notazizelse/camp/docs/images/pcb-top.png

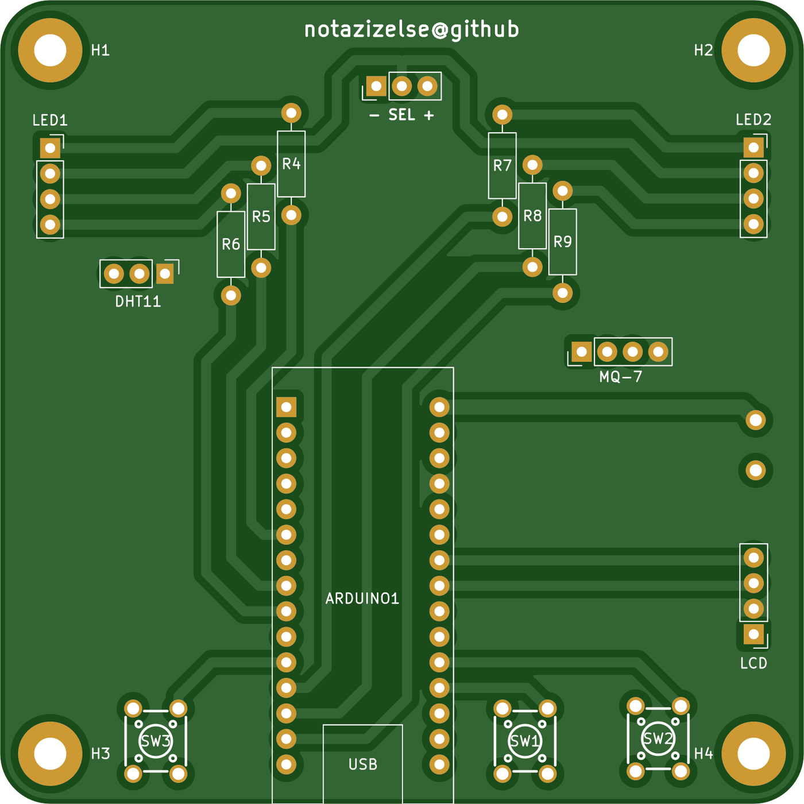
docs/images/pcb-top.png
