notazizelse/camp/production/smeta_cubesat_camp_19-20.09.2026.xlsx

Sheet: Смета
СМЕТА — TechnoCamp CubeSat, 19–20 сентября 2026
Плата campv2 (80×80 мм, 2 слоя) · 25 учеников · 25 CubeSat · 30 плат · 2 дня по 6–7 ч · 1 преподаватель + 3 ассистента
Все цены в USD. Цены JLCPCB — живая котировка jlcpcb.com от 08.09.2026. Остальные цены — оценка розничного рынка Ташкента на сентябрь 2026; уточните у поставщика.
ПАРАМЕТРЫ (жёлтые ячейки можно менять — количества пересчитаются)
Учеников (= CubeSat) | 25
Плат заказываем | 30
Паяльных станций | 12
Дней лагеря | 2
Часов в день | 6.5
№ | Позиция | Зачем нужно | Кол-во | Ед. | Цена, $ | Сумма, $ | Статус | Где брать | Примечание
A. ПЕЧАТНЫЕ ПЛАТЫ — JLCPCB
1 | Изготовление 30 плат 80×80 мм, 2 слоя, FR-4, HASL, зелёная | Основа CubeSat | 1 | заказ | $30.00 | $30.00 | Купить | JLCPCB | Котировка на 50 шт от 08.09.2026: инж. сбор $8.00 + плёнки $1.80 + платы $23.70 = $33.50. Для 30 шт немного меньше
2 | Ускорение производства до 2–3 дней | Иначе платы не успевают к 19 сентября | 1 | опция | $12.30 | $12.30 | Купить | JLCPCB | КРИТИЧНО. Стандартный срок 5–6 дней даёт прибытие 17–21 сентября — риск
3 | Доставка DHL Express (DDP) до Ташкента, ~1 кг | 2–4 рабочих дня | 1 | доставка | $30.48 | $30.48 | Купить | JLCPCB | Сайт сам определил Узбекистан как страну доставки
4 | Купон новичка JLCPCB | Скидка при первом заказе | 1 | скидка | -$20.00 | -$20.00 | Купить | JLCPCB | Применяется, если аккаунт новый. Если нет — уберите строку
 | Итого по разделу «A» |  |  |  |  | $52.78
B. КОМПОНЕНТЫ НА ПЛАТУ (на 30 плат + запас)
5 | Arduino Nano V3, CH340/CH9102, распаянный | Мозг CubeSat, 1 на плату | 35 | шт | $4.00 | $140.00 | Купить | Ташкент, радиорынок | +5 в запас: новички их убивают перегревом и переполюсовкой
6 | Гребёнка-мама PBS 1×40 (режется на 2 шт по 15) | Панельки под Nano — съёмный и защищён от перегрева | 35 | шт | $0.50 | $17.50 | Купить | Ташкент | ОБЯЗАТЕЛЬНО. Заливка +5V идёт по всей лицевой стороне под Nano — прямая пайка рискует замыканием
7 | Резистор 220 Ом, 0.25 Вт, выводной | Токоограничение RGB, 6 шт на плату | 250 | шт | $0.02 | $5.00 | Купить | Ташкент | 30 плат × 6 = 180 + запас на потери
8 | Кнопка тактовая 6×6×5 мм, 4 вывода | SW1–SW3, переключение экранов | 110 | шт | $0.07 | $7.70 | Купить | Ташкент | 30 × 3 = 90 + запас
9 | RGB светодиод 5 мм, 4 вывода, ОБЩИЙ КАТОД | LED2/LED3 — индикация температуры и CO | 75 | шт | $0.25 | $18.75 | Купить | Ташкент | ТОЛЬКО общий катод. Код рассчитан на него (проверено по даташиту LCSC C2837020). Общий анод даст инверсию цветов
10 | Панелька PBS 1×4 | Гнездо под RGB — светодиод съёмный | 70 | шт | $0.10 | $7.00 | Купить | Ташкент | Так задумано в футпринте платы
11 | Гребёнка-папа PLS 1×40 (режется на J2–J5) | Разъёмы датчиков и LCD, 14 контактов на плату | 15 | шт | $0.30 | $4.50 | Купить | Ташкент | 30 плат × 14 = 420 контактов ≈ 11 полосок + запас
12 | Клеммник винтовой DG301, шаг 5 мм, 2 контакта | U1 — вход питания | 35 | шт | $0.30 | $10.50 | Купить | Ташкент | На плате стоит с ОБРАТНОЙ стороны — проверьте, что это так задумано
13 | Джампер-перемычка 2.54 мм | J5: подключает общий вывод RGB к GND | 40 | шт | $0.05 | $2.00 | Купить | Ташкент | Легко забыть при закупке. Без неё светодиоды просто не горят
14 | Стойка латунная M3×10 + винт M3×6 | Крепёж платы к корпусу, 4 комплекта на плату | 120 | компл | $0.12 | $14.40 | Купить | Ташкент | Отверстия на плате 3.2 мм под M3
 | Итого по разделу «B» |  |  |  |  | $227.35
C. ВНЕШНИЕ МОДУЛИ (на 25 CubeSat + запас)
15 | LCD 1602 + плата I2C (PCF8574) | Экран CubeSat, подключается к J3 | 28 | шт | $4.50 | $126.00 | Купить | Ташкент | I2C-адрес 0x27 или 0x3F — в коде есть переключатель LCD_ADDRESS
16 | Модуль DHT11, 3-выводной | Температура и влажность, к J2 | 28 | шт | $2.00 | $56.00 | Купить | Ташкент | ПРОВЕРИТЬ порядок выводов: плата ждёт 5V–DATA–GND, у части модулей S–+–−
17 | Модуль MQ-7 (угарный газ) | Датчик CO, к J4 | 28 | шт | $3.50 | $98.00 | Купить | Ташкент | Нагреватель ест ~150 мА. Нужен прогрев 24–48 ч до калибровки — включите за день до лагеря
18 | Провода Dupont мама-мама 20 см, набор 40 шт | Подключение модулей, 11 проводов на CubeSat | 12 | набор | $2.00 | $24.00 | Купить | Ташкент | 25 CubeSat × 11 = 275 проводов
 | Итого по разделу «C» |  |  |  |  | $304.00
D. ПИТАНИЕ CUBESAT (2×18650 Li-ion)
19 | Аккумулятор 18650 Li-ion, 2000–2600 мА·ч, брендовый | 2 шт последовательно = 7.4 В на клеммник | 56 | шт | $3.50 | $196.00 | Купить | Ташкент | 25 CubeSat × 2 + 6 в запас. НЕ берите ячейки с надписью «9800 mAh» — это восстановленные, ёмкость в 5 раз ниже заявленной
20 | Холдер 2×18650, последовательный, с выводами | Держатель батарей в корпусе | 28 | шт | $1.20 | $33.60 | Купить | Ташкент | Последовательное соединение, не параллельное — нужно 7.4 В
21 | Плата защиты BMS 2S, 8.4 В, 5–10 А | Защита от переразряда, перезаряда и КЗ | 28 | шт | $1.00 | $28.00 | Купить | Ташкент | ОБЯЗАТЕЛЬНО. Li-ion без защиты в руках 25 подростков — это пожар, а не проект
22 | Зарядное устройство 18650, 4 слота, с индикацией | Зарядка ячеек по отдельности | 4 | шт | $9.00 | $36.00 | Купить | Ташкент | Поячеечная зарядка проще и безопаснее балансирного зарядника 2S
23 | Выключатель клавишный на корпус | На плате выключателя нет — CubeSat должен уметь выключаться | 28 | шт | $0.50 | $14.00 | Купить | Ташкент | Ставится в разрыв «+» между BMS и клеммником
24 | Провод AWG22 + термоусадка + клеммные наконечники | Сборка батарейного узла | 1 | компл | $8.00 | $8.00 | Купить | Ташкент
 | Итого по разделу «D» |  |  |  |  | $315.60
E. КОРПУС CUBESAT (лазерная резка, фанера 3–4 мм)
25 | Лазерная резка: комплект деталей корпуса на 1 CubeSat | Каркас спутника | 28 | компл | $2.50 | $70.00 | Купить | Резчик в Ташкенте | Механики в проекте пока нет — макет надо нарисовать до лагеря. Учтите вырез под USB: Nano выступает за край платы на 2.7 мм
26 | Фанера 3 мм, лист 600×600 мм | Материал под резку | 8 | лист | $4.00 | $32.00 | Купить | Строительный рынок | Если резчик работает по давальческому материалу. Иначе входит в цену резки
27 | Термоклеевой пистолет | Сборка корпуса | 4 | шт | $6.00 | $24.00 | Купить | Ташкент
28 | Стержни термоклея 11 мм | Расходник | 40 | шт | $0.15 | $6.00 | Купить | Ташкент
29 | Наждачная бумага P180/P240 | Зачистка кромок фанеры после резки | 20 | лист | $0.25 | $5.00 | Купить | Ташкент
 | Итого по разделу «E» |  |  |  |  | $137.00
F. ПАЯЛЬНОЕ ОБОРУДОВАНИЕ (12 станций)
30 | Паяльная станция с регулировкой температуры, 60 Вт | 12 станций = 2 волны по 12–13 учеников | 12 | шт | $22.00 | $264.00 | Купить | Ташкент | ОБЯЗАТЕЛЬНО с регулировкой. Без неё новички отрывают пятаки и жгут Nano. 3 ассистента × 4 станции — правильная плотность присмотра
31 | Жало сменное, конус / скос 2 мм | Расходник, 2 на станцию | 24 | шт | $1.50 | $36.00 | Купить | Ташкент | За 2 дня новички гарантированно испортят несколько
32 | Коврик силиконовый термостойкий | Защита столов | 12 | шт | $4.00 | $48.00 | Купить | Ташкент
33 | «Третья рука» с лупой | Держать плату при пайке | 12 | шт | $4.00 | $48.00 | Купить | Ташкент | Сильно ускоряет новичка
34 | Бокорезы | Откусывание выводов после пайки | 12 | шт | $2.50 | $30.00 | Купить | Ташкент
35 | Пинцет прямой | Установка мелких деталей | 12 | шт | $1.50 | $18.00 | Купить | Ташкент
36 | Держатель печатной платы | Фиксация при пайке | 6 | шт | $3.00 | $18.00 | Купить | Ташкент
 | Итого по разделу «F» |  |  |  |  | $462.00
G. РАСХОДНИКИ ПАЙКИ
37 | Припой Sn60Pb40, 0.8 мм, с канифолью, 250 г | Основной расходник | 3 | катушка | $8.00 | $24.00 | Купить | Ташкент | Расчёт: 25 плат × 78 точек ≈ 2000 точек × ~0.1 г + тренировка + переделки ≈ 500–750 г
38 | Флюс-гель (или канифоль) | Смачиваемость, чистая пайка | 6 | шт | $2.00 | $12.00 | Купить | Ташкент
39 | Оплётка для выпайки, 2 мм | Снятие соплей и перемычек | 6 | шт | $2.00 | $12.00 | Купить | Ташкент | Понадобится точно: ждите 20–30% плат с ошибками
40 | Отсос для припоя (оловоотсос) | Исправление ошибок | 4 | шт | $4.00 | $16.00 | Купить | Ташкент
41 | Изопропиловый спирт 500 мл + кисти | Отмывка флюса перед проверкой | 2 | компл | $6.00 | $12.00 | Купить | Ташкент
42 | Салфетки безворсовые | Отмывка | 2 | упак | $2.50 | $5.00 | Купить | Ташкент
43 | Макетная плата-обрезок для тренировки | 20 минут тренировки перед реальной платой | 25 | шт | $0.60 | $15.00 | Купить | Ташкент | Ученик не должен учиться паять на своей единственной плате
44 | Набор «учусь паять» (мигающий светодиод) | Быстрая победа до реальной платы | 25 | набор | $1.50 | $37.50 | Купить | Ташкент / AliExpress | Опционально, но сильно поднимает уверенность новичка
 | Итого по разделу «G» |  |  |  |  | $133.50
H. КОНТРОЛЬ И ИЗМЕРЕНИЯ (станция ОТК)
45 | Мультиметр цифровой | ГЛАВНОЕ: прозвонка +5V ↔ GND ДО подачи питания | 5 | шт | $12.00 | $60.00 | Купить | Ташкент | Заливка +5V идёт по всей лицевой стороне: любая сопля на полигон = короткое замыкание. Ни одна плата не включается без этой проверки
46 | USB-тестер тока и напряжения | Бросок тока сразу показывает КЗ | 3 | шт | $6.00 | $18.00 | Купить | Ташкент
47 | Повербанк 5000 мА·ч | ПЕРВОЕ включение платы — только от него | 4 | шт | $8.00 | $32.00 | Купить | Ташкент | Никогда не включать непроверенную плату в порт MacBook
48 | Лупа настольная с подсветкой | Осмотр пайки на станции ОТК | 2 | шт | $15.00 | $30.00 | Купить | Ташкент
 | Итого по разделу «H» |  |  |  |  | $140.00
I. КОМПЬЮТЕРЫ И ПЕРИФЕРИЯ
49 | MacBook Air M5 13" | KiCAD + Arduino IDE, 1 на ученика | 25 | шт | $1199.00 | $29975.00 | Есть | — | В наличии. Указано справочно, чтобы смета отражала полную стоимость программы
50 | Переходник USB-C → USB-A | У MacBook нет USB-A, а Nano подключается через него | 25 | шт | $4.00 | $100.00 | Купить | Ташкент | Без них 25 учеников не смогут прошить ни одной платы
51 | Кабель USB mini-B (или micro-B), 1 м | Прошивка Nano | 30 | шт | $1.50 | $45.00 | Купить | Ташкент | УТОЧНИТЬ тип разъёма на закупленных Nano — бывают и mini, и micro
52 | USB-хаб на 4 порта | Станции массовой прошивки | 4 | шт | $10.00 | $40.00 | Купить | Ташкент
53 | Проектор или большой экран | Разбор схемы и демонстрация KiCAD | 1 | шт | $0.00 | $0.00 | Проверить | — | Уточните наличие в зале — в смете стоит 0
 | Итого по разделу «I» |  |  |  |  | $30160.00
J. БЕЗОПАСНОСТЬ
54 | Дымоуловитель настольный с угольным фильтром | 12 паяльников дают много дыма канифоли | 4 | шт | $18.00 | $72.00 | Купить | Ташкент | Общая вентиляция у вас есть, но локальный отсос у паяльных мест нужен отдельно
55 | Сменные угольные фильтры | Расходник | 8 | шт | $2.00 | $16.00 | Купить | Ташкент
56 | Очки защитные прозрачные | Обрезки выводов летят в глаза | 30 | шт | $1.50 | $45.00 | Купить | Ташкент | Обязательно при откусывании выводов
57 | Огнестойкий бокс для хранения и зарядки Li-ion | Аккумуляторы 18650 хранятся и заряжаются только в нём | 2 | шт | $15.00 | $30.00 | Купить | Ташкент | Заряжать только под присмотром взрослого и никогда не оставлять на ночь без надзора
58 | Аптечка + гель/спрей от ожогов | Ожоги о жало — самая частая травма | 1 | компл | $25.00 | $25.00 | Купить | Аптека
59 | Огнетушитель CO2, 2 кг | Требование безопасности | 1 | шт | $35.00 | $35.00 | Проверить | — | Скорее всего есть в помещении — проверьте до лагеря
 | Итого по разделу «J» |  |  |  |  | $223.00
K. ОРГАНИЗАЦИЯ И МЕТОДИКА
60 | Печать инструкции по сборке, A4 цветная, 4 стр. | Что куда паять, порядок, фото платы | 30 | компл | $0.60 | $18.00 | Купить | Типография | Резко снижает число вопросов к ассистентам
61 | Zip-пакеты для комплектов по ученику | Всё для одного CubeSat в одном пакете | 60 | шт | $0.15 | $9.00 | Купить | Ташкент | Расфасовка заранее экономит около часа в первый день
62 | Наклейки для маркировки комплектов | Имя ученика на пакете и плате | 2 | лист | $1.50 | $3.00 | Купить | Ташкент
63 | Органайзер-контейнер для мелочи | Резисторы, кнопки, светодиоды по ячейкам | 6 | шт | $3.00 | $18.00 | Купить | Ташкент
64 | Маркеры, скотч, стяжки, канцелярия | Прочее | 1 | компл | $15.00 | $15.00 | Купить | Ташкент
 | Итого по разделу «K» |  |  |  |  | $63.00
 | ИТОГО К ЗАКУПКЕ (только строки со статусом «Купить») |  |  |  |  | $2208.23
 | Стоимость на одного ученика (закупка) |  |  |  |  | $88.33
 | Уже в наличии (справочно: ноутбуки, столы, вентиляция, макетки) |  |  |  |  | $29975.00
 | ПОЛНАЯ СТОИМОСТЬ ПРОГРАММЫ (закупка + имеющееся) |  |  |  |  | $32183.23
 | ЛЕГЕНДА: синим на жёлтом — ячейки, которые нужно править (цены и параметры). Чёрным — формулы, их трогать не нужно.
 | Статус «Купить» попадает в итог закупки. Статус «Есть» и «Проверить» — нет.

Sheet: План лагеря
ПЛАН ЛАГЕРЯ — 19–20 сентября 2026
РАСЧЁТ УЗКОГО МЕСТА
Параметр | Значение | Откуда | Комментарий
Точек пайки на плате | 78 | Посчитано по campv2.kicad_pcb: 82 пятака минус 4 крепёжных отверстия
из них панельки под Nano | 30 | Две гребёнки 1×15 — 38% всей работы и самая сложная часть | ПРЕДЛОЖЕНИЕ: припаять их заранее силами взрослых
Остаётся ученику | 48 | Резисторы, кнопки, панельки RGB, разъёмы, клеммник
Скорость новичка | ~75 сек/точка | После 20 минут тренировки, включая подготовку детали и откусывание
Время на плату | ~70 мин | 48 × 75 сек + осмотр | Без предпайки панелек было бы ~95 мин
Всего паяльнико-часов | ~29 ч | 25 учеников × 70 мин
Паяльных станций | 12 | 25 учеников = 2 волны по 12–13 | 3 ассистента × 4 станции — правильная плотность присмотра
Чистое время пайки | ~2.4 ч | 29 ч ÷ 12 станций | Помещается в 2 дня с большим запасом
РОЛИ ВЗРОСЛЫХ
Кто | Роль | Отвечает за | Инструменты
Вы (ведущий) | Трек KiCAD + общее ведение | Теория, разбор схемы, KiCAD, экспорт герберов, тайминг дня | Проектор, MacBook
Ассистент 1 | Паяльный этаж, станции 1–6 | Техника пайки, безопасность, помощь по месту | 6 станций
Ассистент 2 | Паяльный этаж, станции 7–12 | То же | 6 станций
Ассистент 3 | СТАНЦИЯ ОТК | Проверяет КАЖДУЮ плату до подачи питания. Ведёт список переделок | Мультиметр, лупа, повербанк, оплётка, отсос
ПРАВИЛО №1: ни одна плата не включается до прозвонки +5V ↔ GND на станции ОТК. Заливка +5V идёт по всей лицевой стороне — любая сопля на полигон даёт короткое замыкание. Первое включение — только от повербанка, никогда не от MacBook.
ДЕНЬ 1 — суббота 19 сентября (6.5 ч)
Время | Кто | Основное | Параллельно
0:00–0:40 | ВСЕ | Открытие. Что такое CubeSat, разбор схемы на проекторе, показ готового образца | —
0:40–1:00 | ВСЕ | Техника безопасности + демо пайки у одного стола | —
1:00–3:15 | Волна 1 | Группа A (12 чел): 20 мин тренировка на обрезках + 70 мин плата | Группа B (13 чел): KiCAD — схема, символы, цепи
3:15–4:00 | ВСЕ | Обед | —
4:00–6:15 | Волна 2 | Группа B (13 чел): пайка | Группа A (12 чел): KiCAD — разводка платы, экспорт герберов
6:15–6:30 | ВСЕ | Сдача плат на ОТК, итоги дня, список переделок на завтра | —
ДЕНЬ 2 — воскресенье 20 сентября (6.5 ч)
Время | Кто | Основное | Параллельно
0:00–0:45 | ВСЕ | Разбор ошибок с ОТК, переделка проблемных плат (обычно 20–30%) | Ассистенты 1–3 на переделках
0:45–2:15 | ВСЕ | Прошивка: подключение LCD/DHT11/MQ-7, заливка CubeSat.ino, отладка | 25 MacBook — идёт одной волной
2:15–2:30 | ВСЕ | Перерыв | —
2:30–4:15 | ВСЕ | Сборка корпуса CubeSat из фанеры, установка платы на стойки | Термоклей, наждачка
4:15–5:00 | ВСЕ | Обед | —
5:00–6:00 | ВСЕ | Финальная интеграция, калибровка MQ-7, тесты | —
6:00–6:30 | ВСЕ | Демонстрация проектов, фото, закрытие | —
ПИТАНИЕ: 2×18650 (7.4 В) идут на клеммник → вывод VIN Arduino Nano → штатный линейный регулятор AMS1117. При включённом MQ-7 (~150 мА) регулятор рассеивает ~0.6 Вт и заметно греется. Это рабочий режим, но отладку в лагере лучше вести от повербанка через USB, а батареи включать на финальную демонстрацию автономности.

Sheet: Чек-лист подготовки
ЧЕК-ЛИСТ ПОДГОТОВКИ — до 19 сентября
Отмечайте «Готово» в колонке C. Порядок — по срочности.
№ | Что сделать | Срок | Кто | Почему это важно
1 | Исправить шелкографию: подписи выводов J2/J3/J4/J5, маркер 1-го вывода | 9 сентября | Вы | Без подписей 25 новичков перепутают подключение датчиков
2 | Перенести метки «+»/«−» клеммника со слоя F.Cu на B.SilkS | 9 сентября | Вы | Сейчас они на слое меди и не видны под маской. Переполюсовка = мёртвый Nano
3 | Проверить, что U1 (клеммник) на обратной стороне — это задумано | 9 сентября | Вы | Все остальные компоненты на лицевой стороне
4 | Экспортировать герберы (Plot → Gerber + Drill Files), упаковать в zip | 9 сентября | Вы | В production/ сейчас только PDF
5 | ЗАКАЗАТЬ 30 плат на JLCPCB с ускорением 2–3 дня | 9 сентября | Вы | КРИТИЧЕСКИЙ ПУТЬ. Стандартный срок не успевает к 19-му
6 | Проверить один Arduino Nano на одном MacBook: драйвер CH340/CH9102, Old Bootloader | 10 сентября | Вы | Если не заведётся — будет неделя на решение, а не 25 злых учеников
7 | Уточнить тип USB-разъёма на закупаемых Nano (mini-B или micro-B) | 10 сентября | Вы | Кабели надо купить под него
8 | Купить RGB-светодиоды — ТОЛЬКО общий катод | 10–12 сентября | Вы | Общий анод даст инверсию цветов, код придётся переписывать
9 | Проверить порядок выводов реального модуля DHT11 против платы (5V–DATA–GND) | 10–12 сентября | Вы | Обратный порядок сожжёт модуль
10 | Закупить компоненты и модули по разделам B и C | 10–14 сентября | Вы | Основная закупка
11 | Закупить 12 паяльных станций и расходники (разделы E, F) | 10–14 сентября | Вы | Сейчас паяльников нет ни одного
12 | Нарисовать макет корпуса CubeSat под лазерную резку | 10–14 сентября | Вы | Механики в проекте нет. Не забыть вырез под USB: Nano выступает за край платы на 2.7 мм
13 | Отдать корпуса в резку (28 комплектов) | 14 сентября | Вы | Нужен запас времени у резчика
14 | Получить платы от DHL, проверить визуально 2–3 штуки | 15–17 сентября | Вы
15 | Собрать и прошить одну эталонную плату целиком | 17 сентября | Вы | Пока не собрана ни одна — в лагере вылезут сюрпризы
16 | Припаять панельки 2×15 под Nano на все 30 плат | 17–18 сентября | Все взрослые | 30 плат × 6 мин = 3 ч на четверых по 45 мин. Снимает 38% работы с учеников
17 | Включить MQ-7 модули на прогрев на 24–48 ч | 17–18 сентября | Вы | Без прогрева показания CO будут мусором
18 | Расфасовать комплекты по zip-пакетам с именами учеников | 18 сентября | Все взрослые | Экономит около часа в первый день
19 | Напечатать инструкции по сборке (30 комплектов) | 18 сентября | Вы
20 | Разложить зал: 12 паяльных мест, станция ОТК, 25 мест под ноутбуки | 18 сентября | Все взрослые
21 | Собрать один батарейный узел 2S18650 + BMS + выключатель и замерить | 17 сентября | Вы | Проверить напряжение на клеммнике (7.2–8.4 В) до того, как его увидят ученики
22 | На эталонной плате замерить нагрев регулятора Nano при включённом MQ-7 | 17 сентября | Вы | Если корпус регулятора горячее ~100 °C — переводите отладку на повербанки, батареи оставьте для финального показа
23 | Зарядить все 56 аккумуляторов 18650 до 4.1–4.2 В | 18 сентября | Вы | Только в огнестойком боксе, под присмотром, не на ночь
24 | Провести инструктаж по Li-ion: не замыкать, не греть, не разбирать | 19 сентября, утро | Вы | Отдельно от инструктажа по пайке, в самом начале дня
