notazizelse/camp/production/3d.step

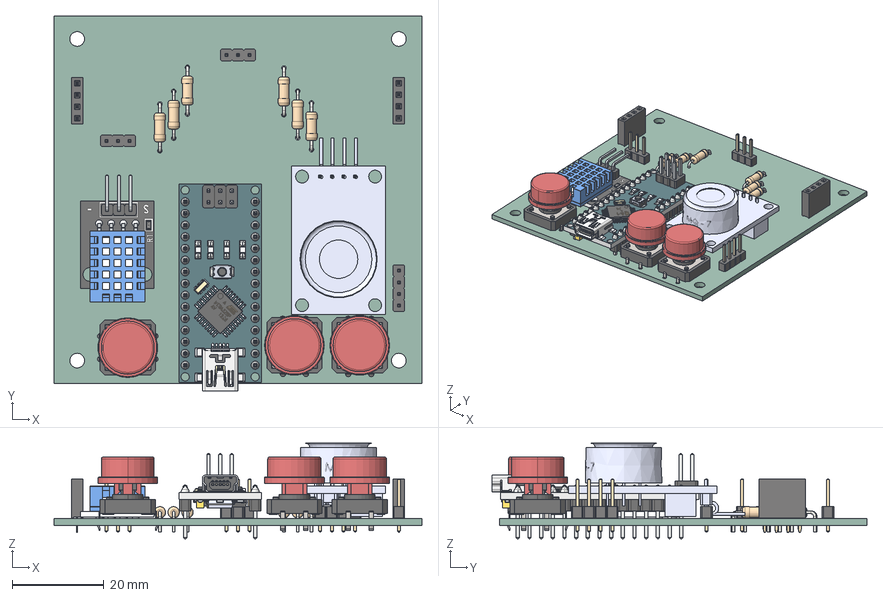
[picture p7: CAD file, 2026-09-09]
production/3d.step
80.0 x 81.6 x 20.8 mm
12mm Push Button x 3
12mm Push Button Cap x 3
R_Axial_DIN0207_L63mm_D25mm_P1016mm_Horizontal x 6
PinHeader_1x03_P254mm_Vertical x 2
(Unsaved)
PinHeader_1x04_P254mm_Vertical x 2
PinSocket_1x04_P2.54mm_Vertical x 2
nano-board
2pin_header__02 x 3
15pin_header__ x 2
atmega328
ftdi FT232rl
smt_resistor222 x 5
led x 4
16mhz crystal - measured
MINIUSBSHELL
MINIUSBCORE
MINI USB CONTACT x 5
cap106C x 2
reset core
reset shell
nano - reg
NANO DIODE
189 RESISTOR PACK
102 RESISTOR PACK
campv2_PCB
