notazizelse/camp/production/camp-F_Cu.pdf

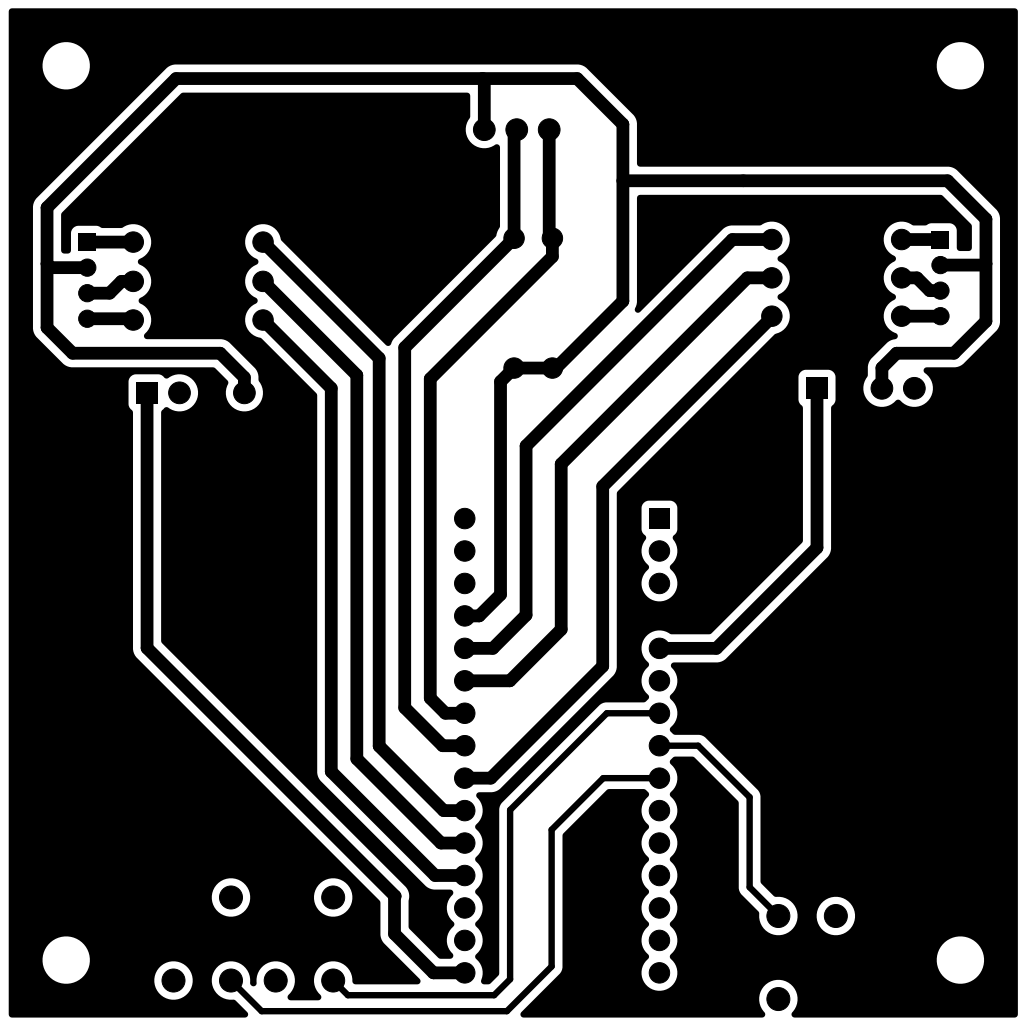
[picture p8: page 1]
