notazizelse/camp/production/campv2-Edge_Cuts.pdf

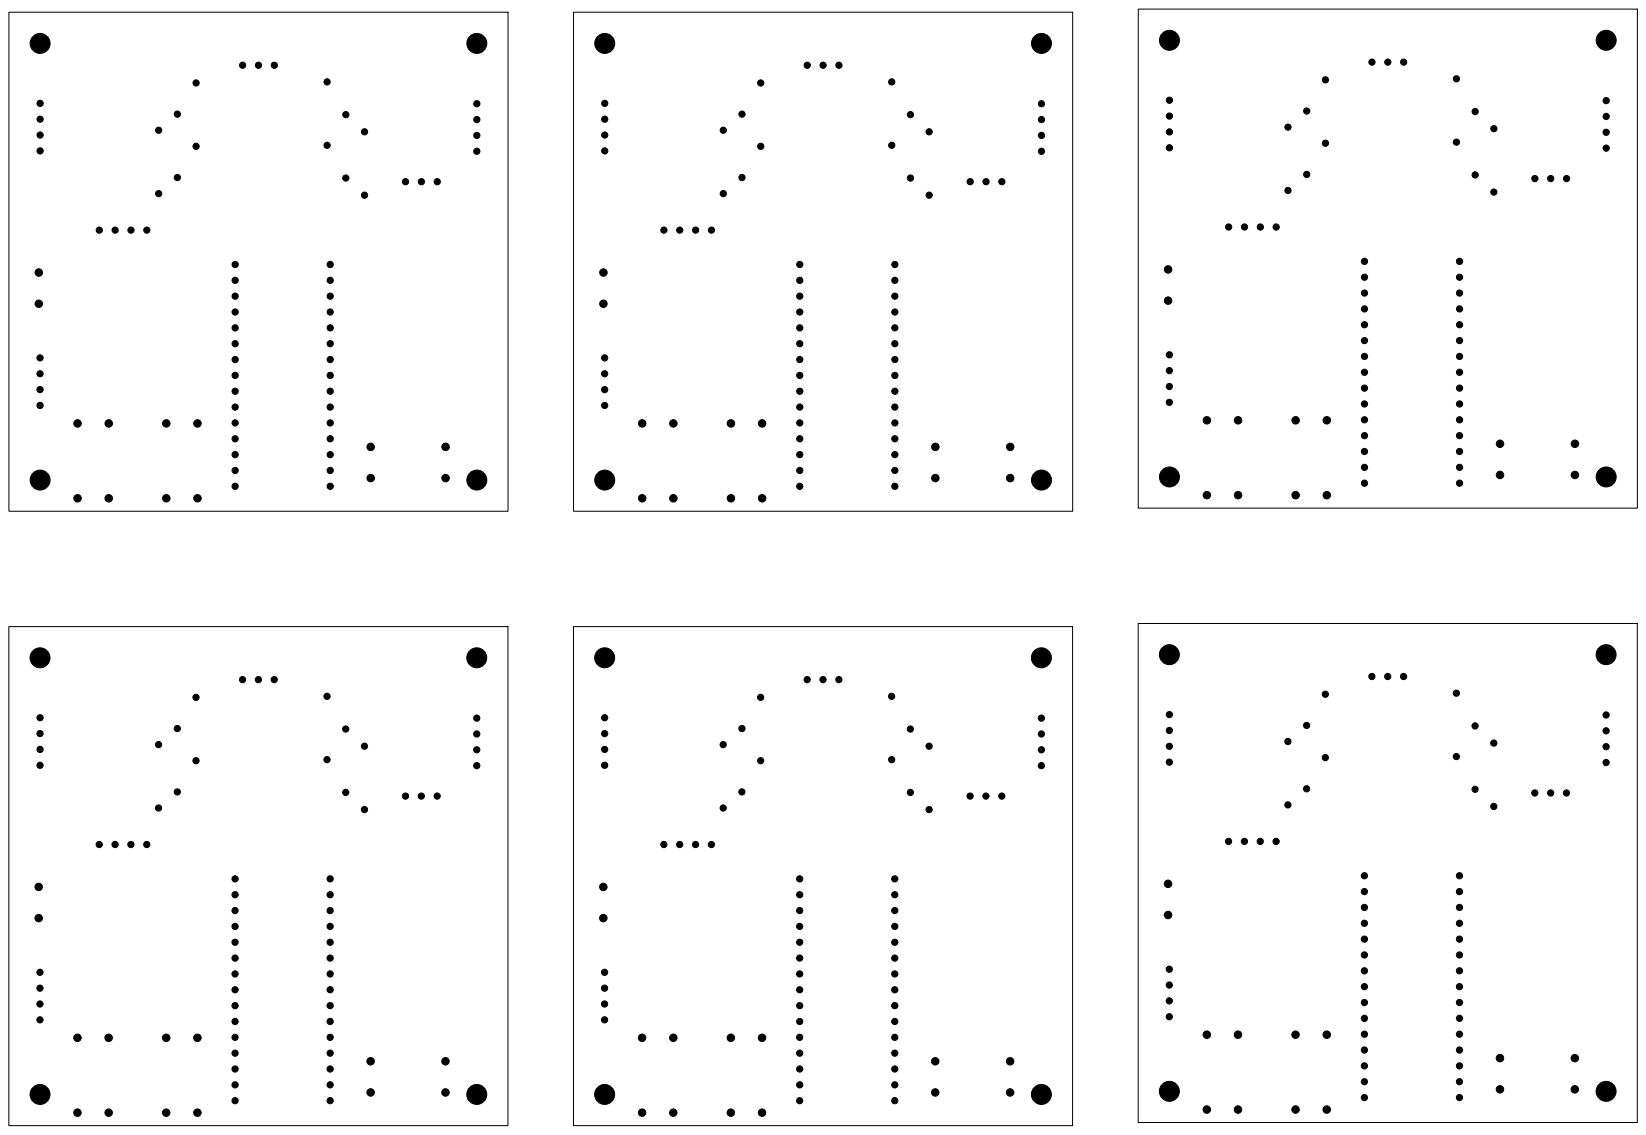
[picture p9: page 1]
