notazizelse/camp/production/campv2-F_Cu.pdf

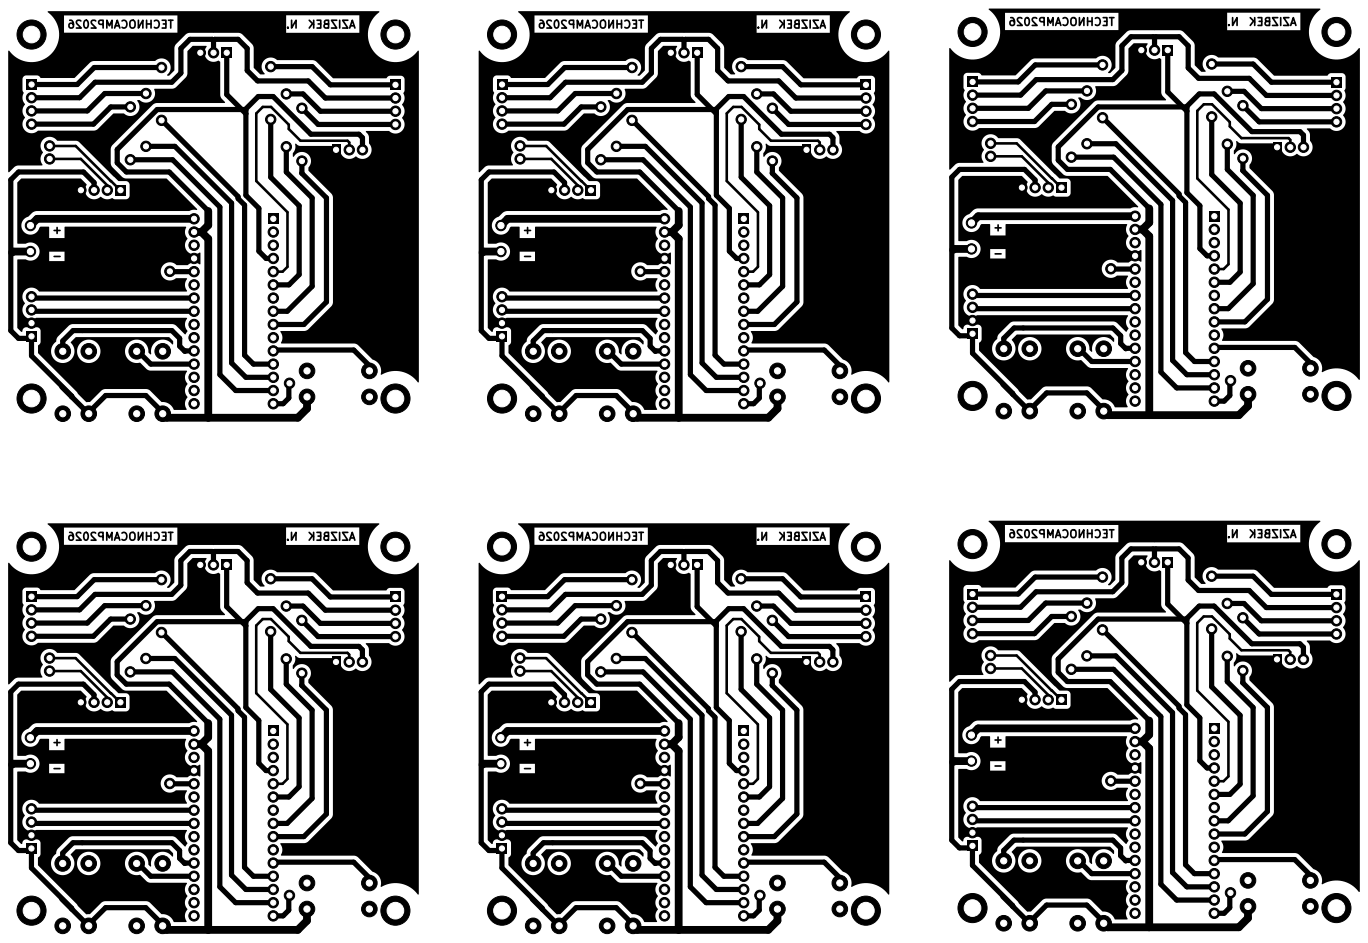
[picture p10: page 1]
