notazizelse/camp/archive/camp/camp-F_Cu.pdf

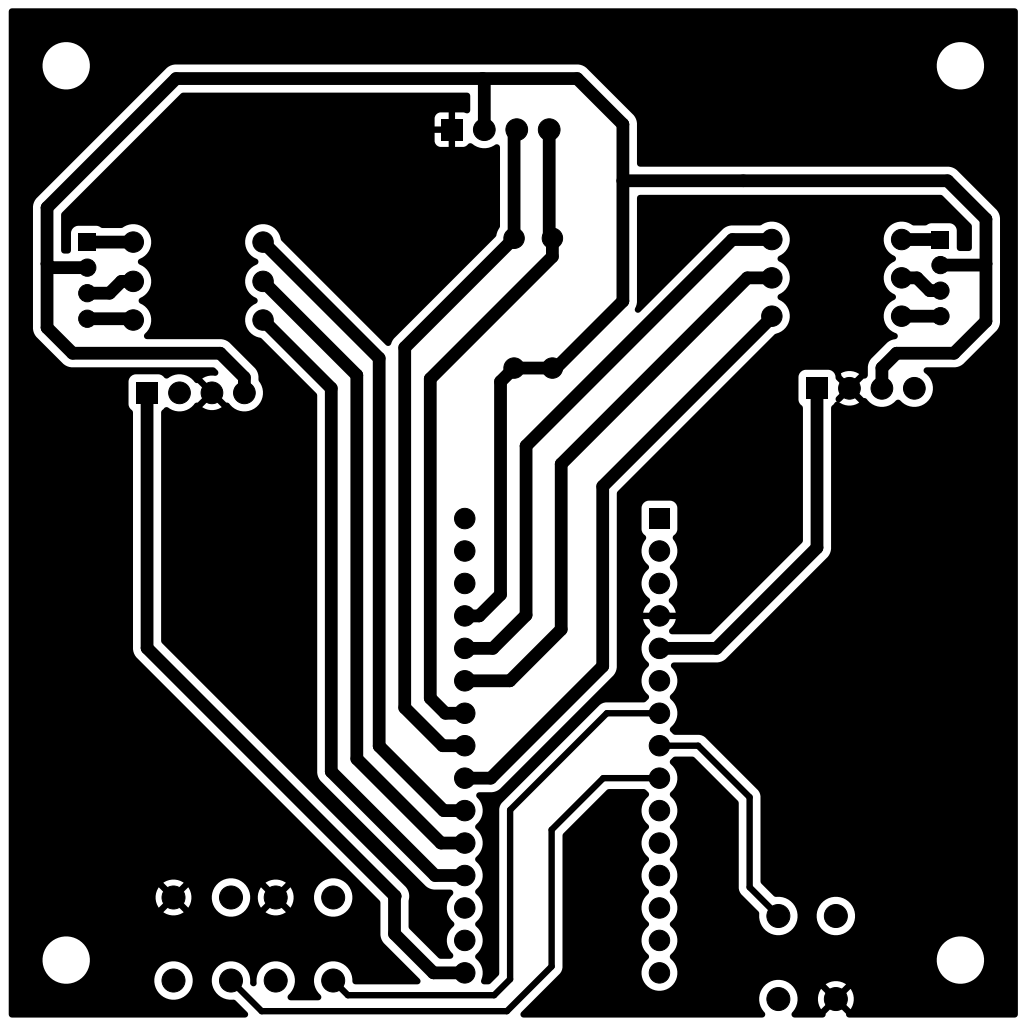
[picture p11: page 1]
