notazizelse/camp/campv2/campv2.kicad_pcb

## KiCad design campv2/campv2.kicad_pcb (2026-09-09)

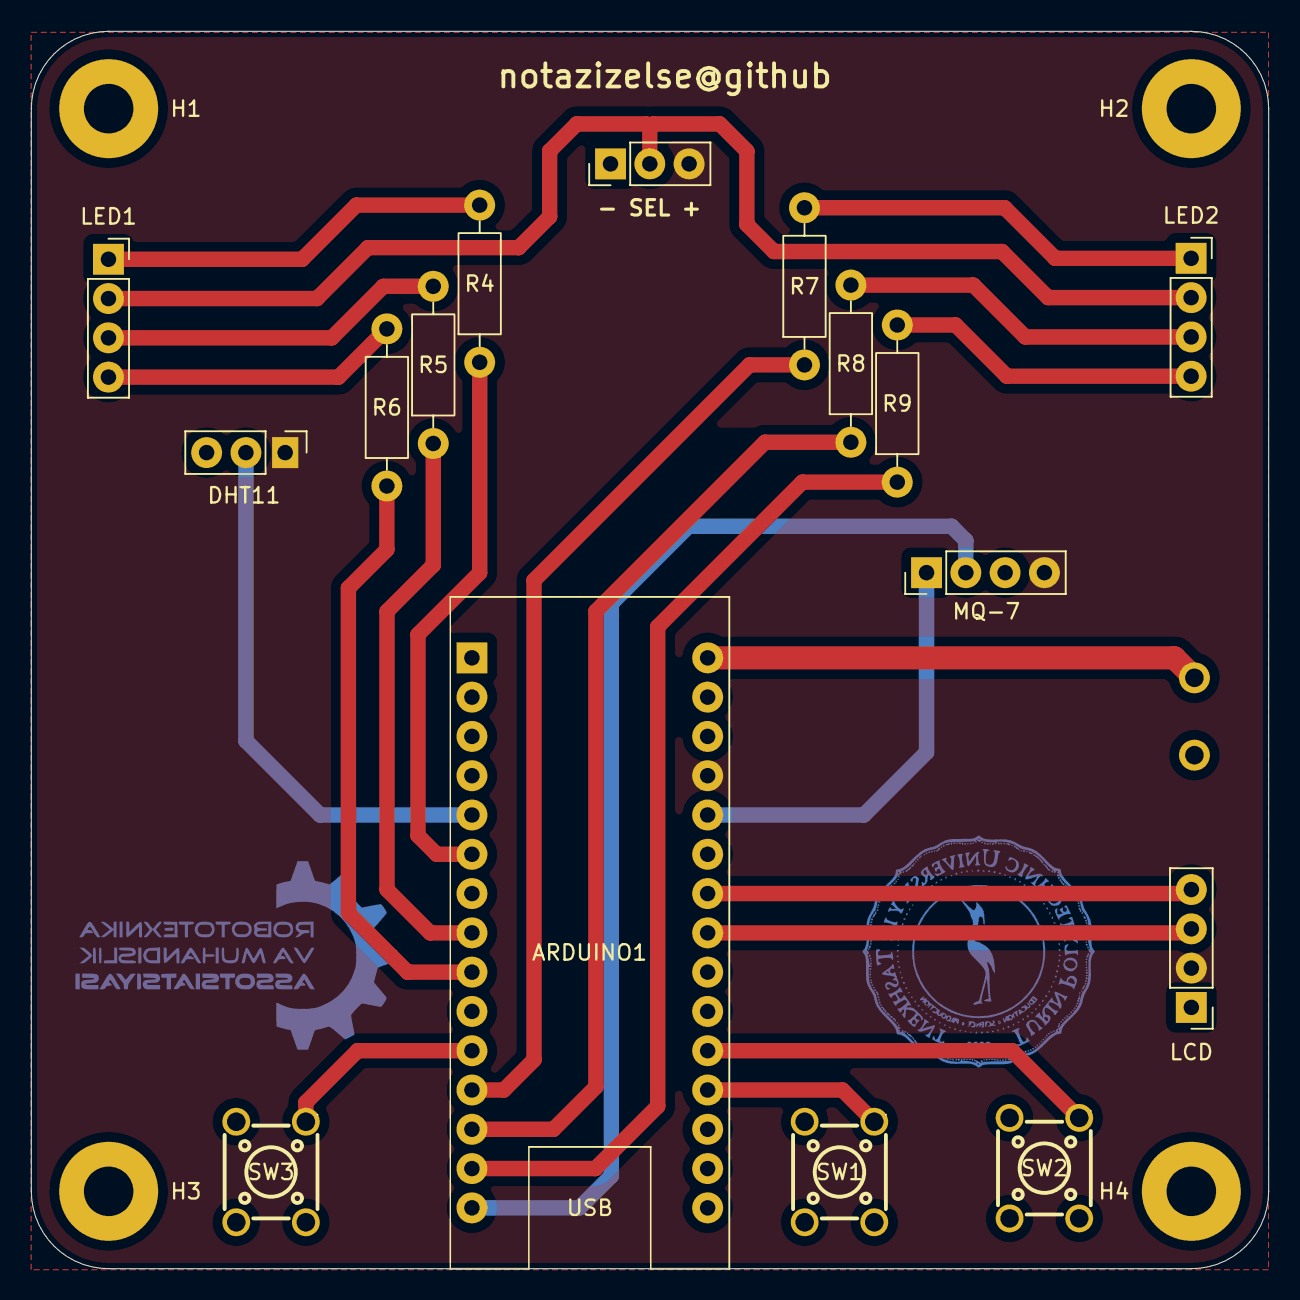
[picture p12: board campv2.kicad_pcb from above]

Board: 2 copper layers, 80.0 x 80.0 mm, 21 parts (1 on the bottom side), 24 nets.

Parts:
ARDUINO1: Arduino_Nano
DHT11: DHT11; PinHeader_1x03_P2.54mm_Vertical
H1, H2, H3, H4: MountingHole_Pad; MountingHole_3.2mm_M3_Pad
J5: LED_SEL; PinHeader_1x03_P2.54mm_Vertical
LCD: LCD; PinHeader_1x04_P2.54mm_Vertical
LED1, LED2: TJ-L5FCMXHTCSLCRGB-A5; PinSocket_1x04_P2.54mm_Vertical
MQ-7: MQ-7; PinHeader_1x04_P2.54mm_Vertical
R4, R5, R6, R7, R8, R9: 220; R_Axial_DIN0207_L6.3mm_D2.5mm_P10.16mm_Horizontal
SW1, SW2, SW3: button; SW-TH_4P-L6.0-W6.0-P4.50-LS6.5
U1: screw terminal; CONN-TH_DEGSON_DG301-5.0-02P

Connections:
+5V: ARDUINO1.27 (+5V), DHT11.1, J5.3, LCD.2, MQ-7.4
/A0: ARDUINO1.19 (A0), SW1.1
/A1: ARDUINO1.20 (A1), SW2.1
/A4: ARDUINO1.23 (A4), LCD.3
/A5: ARDUINO1.24 (A5), LCD.4
/A7: ARDUINO1.26 (A7), MQ-7.1
/D2: ARDUINO1.5 (D2), DHT11.2
/D3: ARDUINO1.6 (D3), R4.1
/D5: ARDUINO1.8 (D5), R5.1
/D6: ARDUINO1.9 (D6), R6.1
/D8: ARDUINO1.11 (D8), SW3.1
/D9: ARDUINO1.12 (D9), R7.1
/D10: ARDUINO1.13 (D10), R8.1
/D11: ARDUINO1.14 (D11), R9.1
/D12: ARDUINO1.15 (D12), MQ-7.2
GND: ARDUINO1.4 (GND), ARDUINO1.29 (GND), DHT11.3, H1.1 (1_1), H2.1 (1_1), H3.1 (1_1), H4.1 (1_1), J5.1, LCD.1, MQ-7.3, SW1.4, SW2.4, SW3.4, U1.2
unnamed: J5.2, LED1.2 (A), LED2.2 (A)
unnamed: LED1.1 (A), R4.2
unnamed: LED1.3 (A), R5.2
unnamed: LED1.4 (A), R6.2
unnamed: LED2.1 (A), R7.2
unnamed: LED2.3 (A), R8.2
unnamed: LED2.4 (A), R9.2
VCC: ARDUINO1.30 (VIN), U1.1
